Silicon4/-HAL-/(list of files, drawings)

Other design files:
我的平衡车主板/我的平衡车工程.PrjPcb
我的平衡车主板/我的底板.PcbDoc
我的平衡车主板/我的底板.PcbLib
我的平衡车主板/我的底板.SchDoc
我的平衡车主板/我的底板.SchLib
遥控器AD工程/遥控器/遥控器1.0.SchDoc
遥控器AD工程/遥控器/遥控器.PrjPcb
