Silicon4/-HAL-/Proj3.1(BlueTooth Control)/SYSTEM/sys/sys.h

#ifndef __SYS_H
#define __SYS_H	
#include "stm32f1xx.h"


//0,不支持ucos
//1,支持ucos
#define SYSTEM_SUPPORT_OS		0		//定义系统文件夹是否支持UCOS
	///////////////////////////////////////////////////////////////////////////////////
//定义一些常用的数据类型短关键字 
typedef int32_t  s32;
typedef int16_t s16;
typedef int8_t  s8;

typedef const int32_t sc32;  
typedef const int16_t sc16;  
typedef const int8_t sc8;  

typedef __IO int32_t  vs32;
typedef __IO int16_t  vs16;
typedef __IO int8_t   vs8;

typedef __I int32_t vsc32;  
typedef __I int16_t vsc16; 
typedef __I int8_t vsc8;   

typedef uint32_t  u32;
typedef uint16_t u16;
typedef uint8_t  u8;

typedef const uint32_t uc32;  
typedef const uint16_t uc16;  
typedef const uint8_t uc8; 

typedef __IO uint32_t  vu32;
typedef __IO uint16_t vu16;
typedef __IO uint8_t  vu8;

typedef __I uint32_t vuc32;  
typedef __I uint16_t vuc16; 
typedef __I uint8_t vuc8;  																    
	 
//位带操作,实现51类似的GPIO控制功能
//具体实现思想,参考<<CM3权威指南>>第五章(87页~92页).
//IO口操作宏定义
#define BITBAND(addr, bitnum) ((addr & 0xF0000000)+0x2000000+((addr &0xFFFFF)<<5)+(bitnum<<2)) 
#define MEM_ADDR(addr)  *((volatile unsigned long  *)(addr)) 
#define BIT_ADDR(addr, bitnum)   MEM_ADDR(BITBAND(addr, bitnum)) 
//IO口地址映射
#define GPIOA_ODR_Addr    (GPIOA_BASE+12) //0x4001080C 
#define GPIOB_ODR_Addr    (GPIOB_BASE+12) //0x40010C0C 
#define GPIOC_ODR_Addr    (GPIOC_BASE+12) //0x4001100C 
#define GPIOD_ODR_Addr    (GPIOD_BASE+12) //0x4001140C 
#define GPIOE_ODR_Addr    (GPIOE_BASE+12) //0x4001180C 
#define GPIOF_ODR_Addr    (GPIOF_BASE+12) //0x40011A0C    
#define GPIOG_ODR_Addr    (GPIOG_BASE+12) //0x40011E0C    

#define GPIOA_IDR_Addr    (GPIOA_BASE+8) //0x40010808 
#define GPIOB_IDR_Addr    (GPIOB_BASE+8) //0x40010C08 
#define GPIOC_IDR_Addr    (GPIOC_BASE+8) //0x40011008 
#define GPIOD_IDR_Addr    (GPIOD_BASE+8) //0x40011408 
#define GPIOE_IDR_Addr    (GPIOE_BASE+8) //0x40011808 
#define GPIOF_IDR_Addr    (GPIOF_BASE+8) //0x40011A08 
#define GPIOG_IDR_Addr    (GPIOG_BASE+8) //0x40011E08 
 
//IO口操作,只对单一的IO口!
//确保n的值小于16!
#define PAout(n)   BIT_ADDR(GPIOA_ODR_Addr,n)  //输出 
#define PAin(n)    BIT_ADDR(GPIOA_IDR_Addr,n)  //输入 

#define PBout(n)   BIT_ADDR(GPIOB_ODR_Addr,n)  //输出 
#define PBin(n)    BIT_ADDR(GPIOB_IDR_Addr,n)  //输入 

#define PCout(n)   BIT_ADDR(GPIOC_ODR_Addr,n)  //输出 
#define PCin(n)    BIT_ADDR(GPIOC_IDR_Addr,n)  //输入 

#define PDout(n)   BIT_ADDR(GPIOD_ODR_Addr,n)  //输出 
#define PDin(n)    BIT_ADDR(GPIOD_IDR_Addr,n)  //输入 

#define PEout(n)   BIT_ADDR(GPIOE_ODR_Addr,n)  //输出 
#define PEin(n)    BIT_ADDR(GPIOE_IDR_Addr,n)  //输入

#define PFout(n)   BIT_ADDR(GPIOF_ODR_Addr,n)  //输出 
#define PFin(n)    BIT_ADDR(GPIOF_IDR_Addr,n)  //输入

#define PGout(n)   BIT_ADDR(GPIOG_ODR_Addr,n)  //输出 
#define PGin(n)    BIT_ADDR(GPIOG_IDR_Addr,n)  //输入


#include "MOTOR.h"
#include "CONTROL.h"
#include "encoder.h"
#include "exti.h"

#include "key.h"
#include "led.h"
#include "adc.h"
#include "delay.h"

#include "IOI2C.h"
#include "mpu6050.h"
#include "inv_mpu.h"
#include "inv_mpu_dmp_motion_driver.h"
#include "dmpKey.h"
#include "dmpmap.h"
#include "usart3.h"
#include "timer.h"

#include <stdio.h>
#include <stdint.h>
#include <stdlib.h>
#include <string.h>
#include <math.h>



/*控制全局变量*************************************/
extern u8 Way_Angle;                                      //获取角度的算法，1：四元数  2：卡尔曼  3：互补滤波
extern int Encoder_Left,Encoder_Right;                     //左右编码器的脉冲计数
extern int Moto1,Moto2;                                     //电机PWM变量 应是motor的 向moto致敬	
extern u8 Flag_Qian,Flag_Hou,Flag_Left,Flag_Right,Flag_sudu; //蓝牙遥控相关的变量
extern u8 Flag_Stop,Flag_Show;                               //停止标志位和 显示标志位 默认停止 显示打开
extern int Voltage,Voltage_Zheng,Voltage_Xiao;                //电池电压采样相关的变量
extern float Angle_Balance,Gyro_Balance,Gyro_Turn;           //平衡倾角 平衡陀螺仪 转向陀螺仪
extern float Show_Data_Mb;                                    //全局显示变量，用于显示需要查看的数据
extern int Temperature;
extern u32 Distance;                                           //超声波测距
extern u8 delay_50,delay_flag,Bi_zhang,PID_Send,Flash_Send;
extern float Acceleration_Z;
extern float Balance_Kp,Balance_Kd,Velocity_Kp,Velocity_Ki;
extern u16 PID_Parameter[10],Flash_Parameter[10];
extern u16 ADV[128];
extern u8 CCD_Zhongzhi,CCD_Yuzhi;
extern u8 mode_flag;			//模式切换标志位，0：蓝牙遥控，1：循迹

//JTAG模式设置定义
//JTAG模式设置定义
#define JTAG_SWD_DISABLE   0X02
#define SWD_ENABLE         0X01
#define JTAG_SWD_ENABLE    0X00

void JTAG_Set(u8 mode);
void Stm32_Clock_Init(u32 PLL);					//时钟系统配置

//以下为汇编函数
void WFI_SET(void);		//执行WFI指令
void INTX_DISABLE(void);//关闭所有中断
void INTX_ENABLE(void);	//开启所有中断
void MSR_MSP(u32 addr);	//设置堆栈地址
void MY_NVIC_Init(u8 NVIC_PreemptionPriority,u8 NVIC_SubPriority,u8 NVIC_Channel,u8 NVIC_Group)	;
void MY_NVIC_PriorityGroupConfig(u8 NVIC_Group);

#endif
