Silicon4/-HAL-/Proj3.1(BlueTooth Control)/HARDWARE/ADC/adc.h

#ifndef __ADC_H
#define __ADC_H	
#include "sys.h"
#define Battery_Ch 6
void Dly_us(void);
 void RD_TSL(void) ;
void Adc_Init(void);
u16 Get_Adc(u8 ch);
int Get_battery_volt(void);     
void  ccd_Init(void);
#endif 
