Silicon4/-HAL-/Proj3.1(BlueTooth Control)/HARDWARE/LED/LED.C

#include "led.h"
  /**************************************************************************
作者：平衡小车之家
我的淘宝小店：http://shop114407458.taobao.com/
**************************************************************************/
/**************************************************************************
函数功能：LED接口初始化
入口参数：无 
返回  值：无
**************************************************************************/
void LED_Init(void)
{
	GPIO_InitTypeDef GPIO_Initure;
	__HAL_RCC_GPIOA_CLK_ENABLE();
	
	GPIO_Initure.Pin = GPIO_PIN_4;
	GPIO_Initure.Mode = GPIO_MODE_OUTPUT_PP;
	GPIO_Initure.Pull = GPIO_PULLUP;
	GPIO_Initure.Speed = GPIO_SPEED_FREQ_HIGH;
	
	HAL_GPIO_Init(GPIOA, &GPIO_Initure);
}

/**************************************************************************
函数功能：LED闪烁
入口参数：闪烁频率 
返回  值：无
**************************************************************************/
void Led_Flash(u16 time)
{
	  static int temp;
	  if(0==time) LED=0;
	  else		if(++temp==time)	LED=~LED,temp=0;
}
