Silicon4/-HAL-/Proj3.1(BlueTooth Control)/HARDWARE/US015/US015.c

#include "us015.h"
#include "led.h"
#include "delay.h"
//////////////////////////////////////////////////////////////////////////////////	 
// 利用中断   现超声波触发程序   PB1---Trig 
////////////////////////////////////////////////////////////////////////////////// 

void Trig_Init(void)
{
	GPIO_InitTypeDef GPIO_Initure;

	__HAL_RCC_GPIOB_CLK_ENABLE();
	
	GPIO_Initure.Pin	=	GPIO_PIN_1;			//PB1
	GPIO_Initure.Mode	=	GPIO_MODE_OUTPUT_PP;  	//推挽输出,用于触发超声波
	GPIO_Initure.Pull	=	GPIO_PULLDOWN;		  	//下拉
	GPIO_Initure.Speed	=	GPIO_SPEED_FREQ_HIGH;			//高速
	
	HAL_GPIO_WritePin(GPIOB,GPIO_PIN_1,GPIO_PIN_RESET);
	HAL_GPIO_Init(GPIOB,&GPIO_Initure);
}

void ch1_capture(void)
{	
			TRIG1=1;
			delay_us(20);
			TRIG1=0;
}
