Silicon4/-HAL-/Proj3.1(BlueTooth Control)/HARDWARE/USART3/usart3.c

#include "usart3.h"

u8 Usart3_Receive;

UART_HandleTypeDef huart3;

/* USART3 init function */

void MX_USART3_UART_Init(void)
{

  huart3.Instance = USART3;
  huart3.Init.BaudRate = 9600;
  huart3.Init.WordLength = UART_WORDLENGTH_8B;
  huart3.Init.StopBits = UART_STOPBITS_1;
  huart3.Init.Parity = UART_PARITY_NONE;
  huart3.Init.Mode = UART_MODE_TX_RX;
  huart3.Init.HwFlowCtl = UART_HWCONTROL_NONE;
  huart3.Init.OverSampling = UART_OVERSAMPLING_16;
  HAL_UART_Init(&huart3);
  
  HAL_UART_Receive_IT(&huart3, (uint8_t *)aRxBuffer, RXBUFFERSIZE);	//使能中断接收
}


void USART3_IRQHandler(void)                	
{ 
	HAL_UART_IRQHandler(&huart3);	//调用HAL库中断处理公用函数
	HAL_UART_Receive_IT(&huart3, (uint8_t *)aRxBuffer, RXBUFFERSIZE);	//重新打开串口中断
}
