Silicon4/-HAL-/Proj3.1(BlueTooth Control)/SYSTEM/sys/sys.c

#include "sys.h"

//JTAG模式设置,用于设置JTAG的模式
//mode:jtag,swd模式设置;00,全使能;01,使能SWD;10,全关闭;	   
//#define JTAG_SWD_DISABLE   0X02
//#define SWD_ENABLE         0X01
//#define JTAG_SWD_ENABLE    0X00		  
void JTAG_Set(u8 mode)
{
	u32 temp;
	temp=mode;
	temp<<=25;
	RCC->APB2ENR|=1<<0;     //开启辅助时钟	   
	AFIO->MAPR&=0XF8FFFFFF; //清除MAPR的[26:24]
	AFIO->MAPR|=temp;       //设置jtag模式
}

//时钟系统配置函数
//PLL:选择的倍频数，RCC_PLL_MUL2~RCC_PLL_MUL16
//返回值:0,成功;1,失败
void Stm32_Clock_Init(u32 PLL)
{
    HAL_StatusTypeDef ret = HAL_OK;
    RCC_OscInitTypeDef RCC_OscInitStructure; 
    RCC_ClkInitTypeDef RCC_ClkInitStructure;
    
    RCC_OscInitStructure.OscillatorType=RCC_OSCILLATORTYPE_HSE;    	//时钟源为HSE
    RCC_OscInitStructure.HSEState=RCC_HSE_ON;                      	//打开HSE
	RCC_OscInitStructure.HSEPredivValue=RCC_HSE_PREDIV_DIV1;		//HSE预分频
    RCC_OscInitStructure.PLL.PLLState=RCC_PLL_ON;					//打开PLL
    RCC_OscInitStructure.PLL.PLLSource=RCC_PLLSOURCE_HSE;			//PLL时钟源选择HSE
    RCC_OscInitStructure.PLL.PLLMUL=PLL; 							//主PLL倍频因子
    ret=HAL_RCC_OscConfig(&RCC_OscInitStructure);//初始化
	
    if(ret!=HAL_OK) while(1);
    
    //选中PLL作为系统时钟源并且配置HCLK,PCLK1和PCLK2
    RCC_ClkInitStructure.ClockType=(RCC_CLOCKTYPE_SYSCLK|RCC_CLOCKTYPE_HCLK|RCC_CLOCKTYPE_PCLK1|RCC_CLOCKTYPE_PCLK2);
    RCC_ClkInitStructure.SYSCLKSource=RCC_SYSCLKSOURCE_PLLCLK;		//设置系统时钟时钟源为PLL
    RCC_ClkInitStructure.AHBCLKDivider=RCC_SYSCLK_DIV1;				//AHB分频系数为1
    RCC_ClkInitStructure.APB1CLKDivider=RCC_HCLK_DIV2; 				//APB1分频系数为2
    RCC_ClkInitStructure.APB2CLKDivider=RCC_HCLK_DIV1; 				//APB2分频系数为1
    ret=HAL_RCC_ClockConfig(&RCC_ClkInitStructure,FLASH_LATENCY_2);	//同时设置FLASH延时周期为2WS，也就是3个CPU周期。
		
    if(ret!=HAL_OK) while(1);
}

void MY_NVIC_Init(u8 NVIC_PreemptionPriority,u8 NVIC_SubPriority,u8 NVIC_Channel,u8 NVIC_Group)	 
{ 
	u32 temp;	
	MY_NVIC_PriorityGroupConfig(NVIC_Group);//设置分组
	temp=NVIC_PreemptionPriority<<(4-NVIC_Group);	  
	temp|=NVIC_SubPriority&(0x0f>>NVIC_Group);
	temp&=0xf;//取低四位  
	NVIC->ISER[NVIC_Channel/32]|=(1<<NVIC_Channel%32);//使能中断位(要清除的话,相反操作就OK) 
	NVIC->IP[NVIC_Channel]|=temp<<4;//设置响应优先级和抢断优先级   	    	  				   
} 

void MY_NVIC_PriorityGroupConfig(u8 NVIC_Group)	 
{ 
	u32 temp,temp1;	  
	temp1=(~NVIC_Group)&0x07;//取后三位
	temp1<<=8;
	temp=SCB->AIRCR;  //读取先前的设置
	temp&=0X0000F8FF; //清空先前分组
	temp|=0X05FA0000; //写入钥匙
	temp|=temp1;	   
	SCB->AIRCR=temp;  //设置分组	    	  				   
}
#ifdef  USE_FULL_ASSERT
//当编译提示出错的时候此函数用来报告错误的文件和所在行
//file：指向源文件
//line：指向在文件中的行数
void assert_failed(uint8_t* file, uint32_t line)
{ 
	while (1)
	{
	}
}
#endif
//THUMB指令不支持汇编内联
//采用如下方法实现执行汇编指令WFI  
void WFI_SET(void)
{
	__ASM volatile("wfi");		  
}
//关闭所有中断
void INTX_DISABLE(void)
{		  
	__ASM volatile("cpsid i");
}
//开启所有中断
void INTX_ENABLE(void)
{
	__ASM volatile("cpsie i");		  
}
//设置栈顶地址
//addr:栈顶地址
__asm void MSR_MSP(u32 addr) 
{
    MSR MSP, r0 			//set Main Stack value
    BX r14
}
